onicagroup/sting/doc/resistor_bypass.png

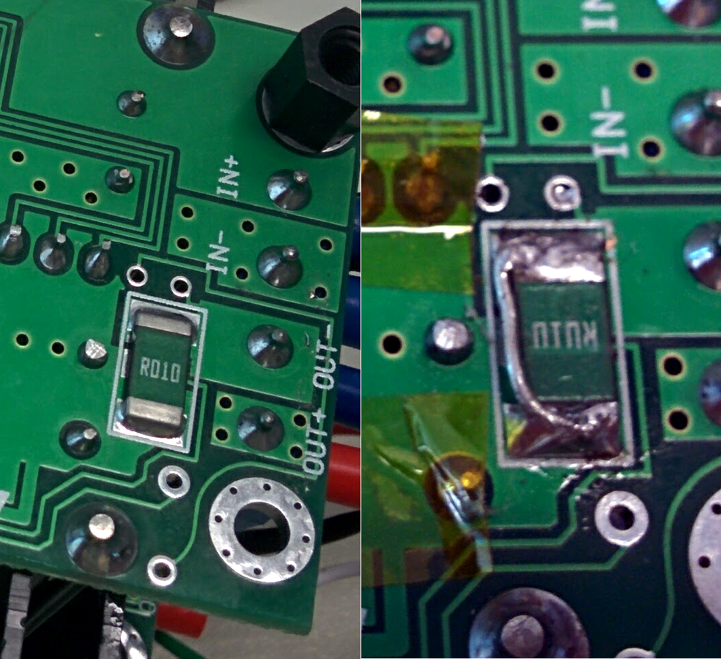
doc/resistor_bypass.png
